TabTwo/Mini-LED-Cube/doc/instructions_back_a4.png

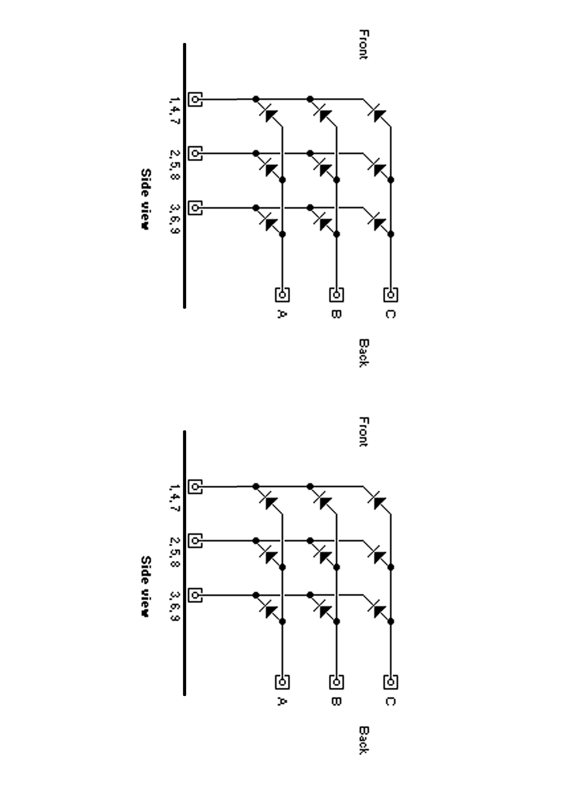
doc/instructions_back_a4.png
