TabTwo/Mini-LED-Cube/doc/instructions_front_a4.png

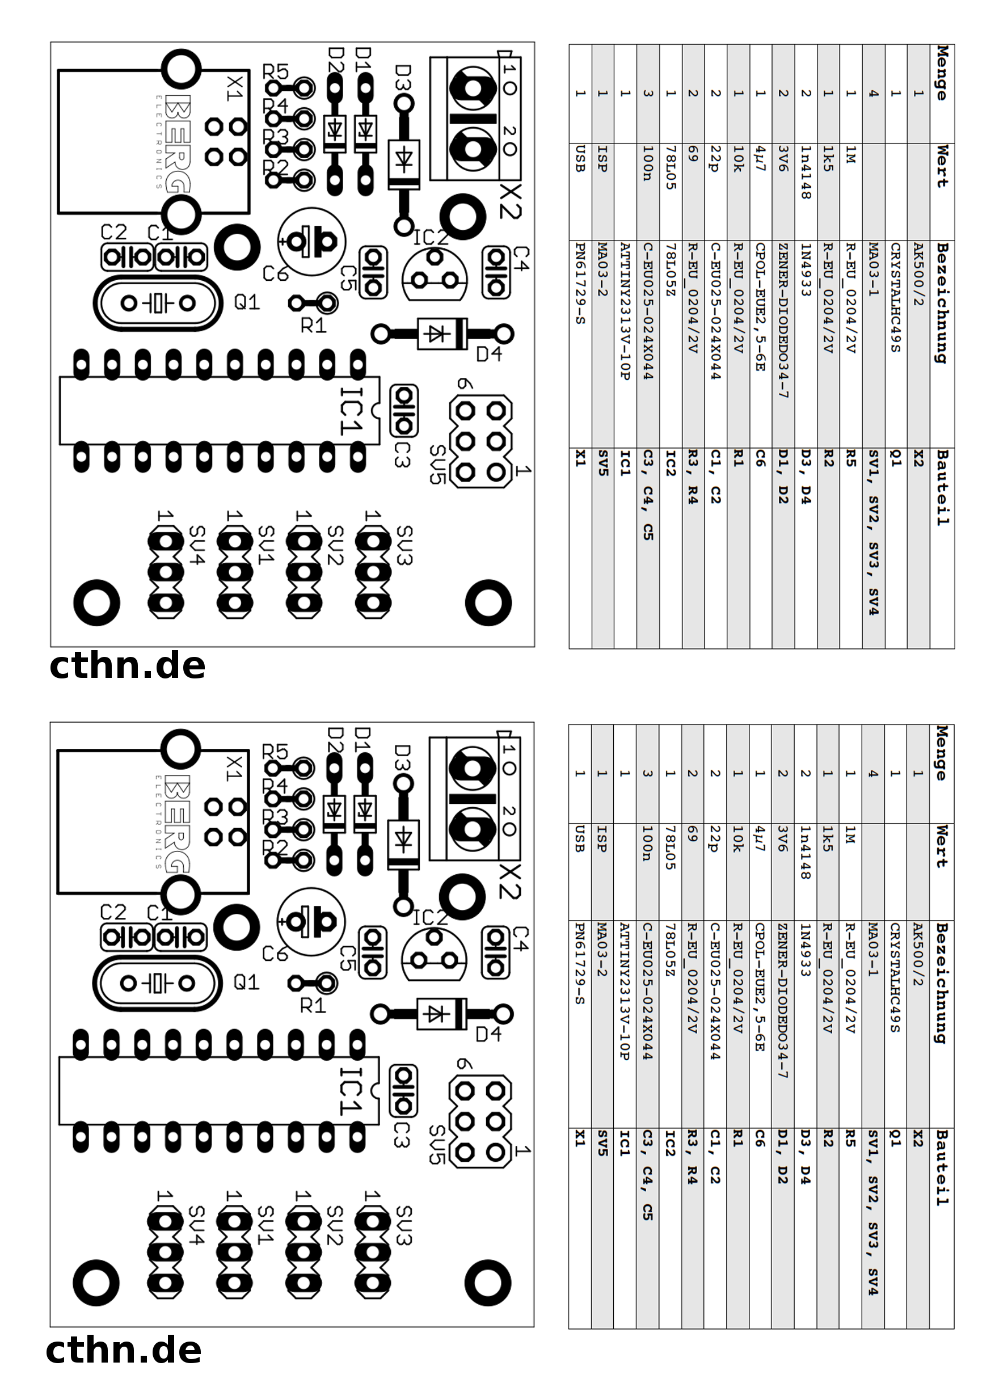
doc/instructions_front_a4.png
