TabTwo/Mini-LED-Cube/(commit log)

2011-09-19 Add the PCB
    [miniledcube.brd, miniledcube.sch]
2011-10-02 Add the label file for the AVR
    Glue it on top of the DIL case for PIN guidance.
2011-10-02 Partlist of the LED cube.
2011-10-05 avrdude options changed in makefile.
    [miniledcube.brd, miniledcube.sch]
2011-10-06 Optional PullDown removed. Ground area added to the board.
    [miniledcube.brd, miniledcube.sch]
2011-10-18 Fixing a bug in the schematics (and the pcb board)
    [miniledcube.brd, miniledcube.sch]
2011-10-18 Some file extensions added which we won't to track.
2011-10-18 Major changes on the core of the framework from klaute
    * Some interferrences with the two timers (usb/led)
    * Big cleanup from the codebase and separate logical parts
    * Documenting the code
    * Big space optimizations on the code to fit on the AVR
    [globals.h, main.c, main.h, usb.c, usb.h, usbconfig.h]
2011-10-18 Start implementing a 3D GUI to configure the cube.
    The idea is to use OpenGL and some simple C code to display a 3D cube.
    With the mouse you can define which LED should be on or off on a
    particular frame. With this technique, you can define whole sequences of
    frames to form animations.
2011-10-20 New version without the usb schematic problem. Board routing removed.
    [miniledcube.brd, miniledcube.sch]
2011-10-20 Fix the "zoom" problem and add some wires in between.
    [config.h, display.c, input.c, main.c]
2011-10-20 Copy from master branch.
    [miniledcube.brd, miniledcube.sch]
2011-10-23 Unused resistor removed.
2011-10-23 Correct some lighting and make real LED models.
    [config.h, display.c, main.c]
2011-10-29 Typo fixed.
    [miniledcube.sch]
2011-10-30 iSome typo fixes and revision updates.
    [miniledcube.brd, miniledcube.sch]
2011-10-30 Add the picking feature.
    We can now select a LED on the screen and get the index of the LED.
    To get the right index, we use the color picking technique mentioned
    in the OpenGL RedBook. This works suprisingly pretty well (and fast!).
2011-10-30 Implement the LED voltage switch.
    LEDs can now be switched on or off with the mouse. The current
    state of the LEd cube is saved in a array which can be easily
    printed out to STDOUT.
2011-11-05 Timer/Counter calculations to configure the new timing requirements.
    [timer_counter.ods]
2011-11-08 Start implementing the GUI for the 3D-LED-Cube
2011-11-29 Timer configured and first implementation of the ISR.
2011-12-07 First working version of the ISR to control the LEDs.
2011-12-07 Fix a display issue with the wires
    [display.c, event_callbacks.c, main.c]
2011-12-18 Mode switching and delay changing examples added.
2011-12-18 Code optimized, delay changing via USB added and animation viewing routine fixed.
    [main.c, main.h, usb.c, usb.h]
2011-12-20 First implementation of a embedded delay information in a single frame.
2011-12-21 Reading the delay out of the 5 most significant bits from the framedata variable frame.
2011-12-21 Add movement and fix some compile bugs
    [event_callbacks.c, input.c, main.c]
2011-12-21 Make The LEDs clickable
2011-12-22 New compiled version with embedded delay support and sample eeprom content.
2011-12-22 LEDCube handling extracted.
2011-12-23 Initial commit of the CTHN LED Cube client.
2011-12-28 Start implementing the connection between LEDCube lib and editor
2011-12-29 Simple tool to convert commandline parameste data to 32bit frame data.
2011-12-30 Sample implementation to parse commandline parameter.
2011-12-31 Sample argument parser inproved.
2011-12-31 Sample usage.
2012-01-04 Single shot animation argument support and frame view parameter added.
2012-01-10 device id not product id
2012-01-11 Glade file path fixed.
    [main.c]
2012-01-12 UDEV rules to access the LEDCube as nonroot user.
2012-01-13 New sample...
2012-01-15 Connect the 3D-Editor with the great client library.
    The editor is now an realtime tool for the LED-Cube!
2012-01-15 More than one frame can be created and uploaded.
